sxivansx/major-project/core/obslam/rig.py

"""The bench rig: one lidar source, one tilt servo, the live point cloud and the step-and-scan job.

Thread model: scan sources and the job run on their own threads; `publish` must be thread-safe
(the server hands in a loop.call_soon_threadsafe wrapper). All rig state is guarded by one RLock.
"""

from __future__ import annotations

import json
import logging
import math
import threading
import time
from pathlib import Path
from typing import Callable, Literal

import numpy as np
from pydantic import BaseModel, Field

from . import wire
from .analysis import OpsParams, analyze
from .audio_pipeline import AudioPipeline
from .config import Config
from .geometry import lidar_to_base
from .grid import Grid, build_grid
from .room import RoomSession
from .slam2d import place_at
from .servo import SerialTilt, SimTilt, TiltError, TiltSource
from .session import SessionStore
from .sim import SimScanSource
from .sources import ScanFrame, ScanSource, ScanStats

log = logging.getLogger(__name__)

POINTS_CHUNK = 50_000


class RigError(Exception):
    pass


class JobParams(BaseModel):
    name: str = "scan"
    phi_start: float = -60.0
    phi_end: float = 60.0
    phi_step: float = Field(2.0, gt=0)
    rotations: int = Field(1, ge=1)
    settle_ms: int = Field(300, ge=0)
    # center_out: 0 → phi_start, back to 0, then 0 → phi_end (the cradle never crosses
    # level in one move). linear: phi_start → phi_end in order.
    pattern: Literal["center_out", "linear"] = "center_out"

    def phis(self) -> np.ndarray:
        if abs(self.phi_end - self.phi_start) < 1e-9:
            return np.array([self.phi_start])
        lo, hi = min(self.phi_start, self.phi_end), max(self.phi_start, self.phi_end)
        if self.pattern == "center_out" and lo < 0 < hi:
            def half(limit: float) -> np.ndarray:  # 0, ±step, ... up to `limit`, ends exactly on it
                n = int(np.floor(abs(limit) / self.phi_step + 1e-9))
                v = np.arange(n + 1) * self.phi_step * np.sign(limit)
                return v if abs(v[-1] - limit) < 1e-9 else np.r_[v, limit]
            first, second = (half(lo), half(hi)) if self.phi_start < 0 else (half(hi), half(lo))
            return np.r_[first, second[1:]]  # level is scanned once
        step = self.phi_step if self.phi_end > self.phi_start else -self.phi_step
        return np.arange(self.phi_start, self.phi_end + step / 2, step)


class Rig:
    def __init__(
        self,
        config: Config,
        sessions: SessionStore,
        publish: Callable[[str | bytes], None],
        bridge_path: Path | None = None,
        sim_hz: float = 10.0,
    ):
        self.config = config
        self.sessions = sessions
        self._publish = publish
        self.bridge_path = bridge_path
        self.sim_hz = sim_hz
        self._lock = threading.RLock()
        self._cv = threading.Condition()

        self.scan: ScanSource | None = None
        self.scan_source: str | None = None
        self.scan_port: str | None = None
        self.scan_baud: int | None = None
        self.scan_info: dict = {}
        self.scan_error: str | None = None
        self.stats = ScanStats()
        self.latest: ScanFrame | None = None
        self.seq = 0
        self._last_scan_pub = 0.0
        self._scan_connected_at = 0.0
        self._alarms: set[str] = set()
        self._alarm_keys: dict[str, str] = {}

        self.tilt: TiltSource | None = None

        self.job: dict | None = None
        self._job_thread: threading.Thread | None = None
        self._job_stop = threading.Event()
        self._job_counter = 0

        self._live: list[np.ndarray] = []
        self._live_cat: np.ndarray | None = None
        self.session_loaded: str | None = None
        self.phi_max_deg = 60.0  # of the sweep that produced the live cloud

        # the microphones are a sibling of the lidar, not part of it: their own source thread,
        # their own lock; they only read the map (through a cached analysis) to name candidates
        self.audio = AudioPipeline(config, publish, self.log, self._audio_findings, publish_json=self.publish_json)
        self.room = RoomSession(publish, self.publish_json, self.log)

    def _audio_findings(self) -> dict | None:
        """Findings for the audio candidates: the same defaults as GET /ops/findings, so the ids
        an event names are the ids the operator sees at the default cell size."""
        xyz = self.live_points()
        if xyz.shape[0] < 1000:
            return None
        return analyze(xyz, OpsParams(), scanner_z_m=self.scanner_z_m(), phi_max_deg=self.phi_max_deg).findings

    def scanner_z_m(self) -> float:
        m = self.config.mount
        return (m.axis_z_mm + m.h_mm) / 1000.0

    # ---- publishing -------------------------------------------------------------------------
    def publish_json(self, obj: dict) -> None:
        self._publish(json.dumps(obj))

    def publish_status(self) -> None:
        self.publish_json({"type": "status", **self.status()})

    def log(self, level: str, msg: str) -> None:
        getattr(log, level if level != "warn" else "warning")(msg)
        self.publish_json({"type": "log", "level": level, "msg": msg, "t": time.time()})

    # ---- status ------------------------------------------------------------------------------
    def phi_now(self) -> float:
        with self._lock:
            if self.tilt is None:
                return 0.0
            return self.config.mount.servo_to_phi(self.tilt.servo_deg)

    def live_points(self) -> np.ndarray:
        with self._lock:
            if self._live_cat is None:
                self._live_cat = np.concatenate(self._live) if self._live else np.zeros((0, 3), np.float32)
            return self._live_cat

    def status(self) -> dict:
        with self._lock:
            lidar = {
                "connected": self.scan is not None,
                "source": self.scan_source,
                "port": self.scan_port,
                "baud": self.scan_baud,
                "model": self.scan_info.get("model"),
                "serial": self.scan_info.get("serial"),
                "firmware": self.scan_info.get("firmware"),
                "hardware": self.scan_info.get("hardware"),
                "health": self.scan_info.get("health"),
                "scan_hz": self.stats.hz,
                "pts_per_rev": self.stats.pts_per_rev,
                "range_min_m": self.stats.range_min,
                "range_max_m": self.stats.range_max,
                "error": self.scan_error,
            }
            t = self.tilt
            meas = t.meas_deg if t else None
            servo = {
                "connected": t is not None,
                "port": t.port if t else None,
                "servo_deg": t.servo_deg if t else None,
                "phi_deg": self.config.mount.servo_to_phi(t.servo_deg) if t else None,
                "min_deg": t.min_deg if t else None,
                "max_deg": t.max_deg if t else None,
                "range": t.range if t else None,
                "meas_deg": meas,
                "phi_meas_deg": self.config.mount.enc_to_phi(meas) if meas is not None else None,
                "encoder": t.encoder if t else None,
                "settled": t.settled if t else None,
            }
            return {
                "lidar": lidar,
                "servo": servo,
                "job": dict(self.job) if self.job else None,
                "live_points": int(self.live_points().shape[0]),
                "session_loaded": self.session_loaded,
                "alarms": sorted(self._alarms),
                "audio": self.audio.status(),
            }

    def check_alarms(self) -> list[str]:
        """Called about once a second. Raises/clears alarms with one log line each."""
        # Keyed by kind, so a changing number (6.3 Hz, then 6.6 Hz) updates one alarm instead of
        # raising and clearing a new one every second. Over Wi-Fi the first seconds after connect
        # replay buffered rotations in bursts, hence the longer grace period.
        alarms: dict[str, str] = {}
        now = time.time()
        self.audio.tick(now)  # outside the rig lock: it may publish
        with self._lock:
            if self.scan is not None and now - self._scan_connected_at > 8.0:
                last_t = self.latest.t if self.latest else self._scan_connected_at
                age = now - last_t
                hz = self.stats.hz
                if age > 2.0:
                    alarms["no_frames"] = f"no lidar frames for {age:.0f} s"
                elif hz is not None and hz < 8.0:
                    alarms["rate"] = f"scan rate low: {hz:.1f} Hz"
                if self.stats.pts_per_rev and self.stats.pts_per_rev < 1000:
                    alarms["points"] = f"only {self.stats.pts_per_rev} points per rotation"
                health = self.scan_info.get("health")
                if health not in (None, "good"):
                    alarms["health"] = f"lidar health {health}"
            if self.scan is None and self.scan_error:
                alarms["died"] = f"lidar stream died: {self.scan_error}"
            job = self.job
            if job and job["state"] == "error":
                alarms["job"] = f"job {job['job_id']} failed: {job['error']}"
            alarms.update(self.audio.alarms())
            old = self._alarm_keys
            raised = [alarms[k] for k in alarms if k not in old]
            cleared = [old[k] for k in old if k not in alarms]
            self._alarm_keys = alarms
            self._alarms = set(alarms.values())
        for a in sorted(raised):
            self.log("warn", f"alarm: {a}")
        for a in sorted(cleared):
            self.log("info", f"cleared: {a}")
        if raised or cleared:
            self.publish_status()
        return sorted(alarms.values())

    def snapshot_csv(self, rotations: int = 1, timeout: float = 5.0) -> bytes:
        """The next `rotations` full rotations at the current tilt, raw, as CSV. For bias measurements."""
        with self._lock:
            if self.scan is None:
                raise RigError("lidar not connected")
        frames = self.wait_frames(rotations, time.time(), timeout)
        phi = self.phi_now()
        rows = ["rotation,t,phi,angle,range,quality"]
        for i, f in enumerate(frames):
            for a, r, q in zip(f.angle.tolist(), f.range.tolist(), f.quality.tolist()):
                rows.append(f"{i},{f.t:.4f},{phi:.2f},{a:.3f},{r:.4f},{q}")
        return ("\n".join(rows) + "\n").encode()

    def metrics(self, cell: float | None = None, z_min=None, z_max=None, floor_band_m: float = 0.1) -> dict:
        """Numbers for the evaluation chapter: coverage, throughput, floor flatness."""
        xyz = self.live_points()
        with self._lock:
            job = dict(self.job) if self.job else None
        n = int(xyz.shape[0])
        out: dict = {"points": n, "steps": None, "points_per_step": None, "duration_s": None}
        if job:
            steps = int(job.get("step") or 0)
            out["steps"] = steps
            out["points_per_step"] = round(n / steps, 1) if steps else None
            end = job.get("finished") or (time.time() if job["state"] == "running" else None)
            out["duration_s"] = round(end - job["started"], 2) if end else None
        g = self.grid(cell, "count", z_min, z_max)
        filled = int(np.isfinite(g.data).sum())
        cells = int(g.w * g.h)
        out["grid"] = {
            "cell_m": g.cell,
            "cells": cells,
            "filled": filled,
            "coverage_pct": round(100.0 * filled / cells, 1) if n else 0.0,
            "points_per_filled_cell": round(n / filled, 1) if filled else None,
        }
        band = xyz[np.abs(xyz[:, 2]) <= floor_band_m] if n else xyz
        if band.shape[0] >= 50:
            a = np.c_[band[:, 0], band[:, 1], np.ones(band.shape[0])].astype(np.float64)
            coef, *_ = np.linalg.lstsq(a, band[:, 2].astype(np.float64), rcond=None)
            resid = band[:, 2] - a @ coef
            out["floor"] = {
                "points": int(band.shape[0]),
                "rms_mm": round(float(np.sqrt(np.mean(resid**2)) * 1000), 1),
                "tilt_deg": round(float(np.degrees(np.arctan(np.hypot(coef[0], coef[1])))), 2),
                "offset_mm": round(float(coef[2] * 1000), 1),
            }
        else:
            out["floor"] = None
        return out

    # ---- lidar -------------------------------------------------------------------------------
    def connect_lidar(self, source: str, port: str | None = None, baud: int = 1_000_000) -> None:
        with self._lock:
            if self.scan is not None:
                raise RigError("lidar already connected")
            if source == "sim":
                src: ScanSource = SimScanSource(self.phi_now, self.config.mount, hz=self.sim_hz)
            elif source == "s2":
                if not port:
                    raise RigError("port required for s2")
                from .s2 import S2ScanSource

                src = S2ScanSource(port, baud, self.bridge_path)
            else:
                raise RigError(f"unknown source {source!r}")
            try:
                info = src.info()
            except RuntimeError as e:
                raise RigError(str(e)) from e
            self.scan, self.scan_source, self.scan_port, self.scan_baud = src, source, port, baud
            self.scan_info, self.scan_error = info, None
            self.stats.reset()
            self.latest = None
            self._scan_connected_at = time.time()
            src.start(self._on_frame, self._on_scan_exit)
        self.log("info", f"lidar connected: {info.get('model')} on {port or 'sim'}")
        self.publish_status()

    def disconnect_lidar(self) -> None:
        with self._lock:
            src, self.scan = self.scan, None
            self.scan_source = self.scan_port = self.scan_baud = None
            self.scan_info = {}
            self.stats.reset()
        if src:
            src.stop()
            self.log("info", "lidar disconnected")
        self.publish_status()

    def _on_frame(self, f: ScanFrame) -> None:
        with self._lock:
            self.stats.update(f)
            self.latest = f
            self.seq += 1
            seq = self.seq
            phi = self.phi_now()
        with self._cv:
            self._cv.notify_all()
        now = time.monotonic()
        if now - self._last_scan_pub >= 0.08:
            self._last_scan_pub = now
            self._publish(wire.encode_scan(seq, f.t, phi, f.angle, f.range, f.quality))
        self.room.feed(f, phi)

    def _on_scan_exit(self, error: str | None) -> None:
        with self._lock:
            self.scan = None
            self.scan_error = error or "lidar stream ended"
        self.log("error", f"lidar stream ended: {error or 'no error reported'}")
        self.publish_status()

    def wait_frames(self, n: int, after: float, timeout: float = 5.0) -> list[ScanFrame]:
        """Collect n frames grabbed after `after` (unix s). Raises RigError on timeout."""
        got: list[ScanFrame] = []
        seen = self.seq
        deadline = time.monotonic() + timeout
        while len(got) < n:
            remaining = deadline - time.monotonic()
            if remaining <= 0:
                raise RigError("timed out waiting for lidar frames")
            with self._cv:
                if self.seq == seen:
                    self._cv.wait(remaining)
            with self._lock:
                if self.scan is None:
                    raise RigError("lidar disconnected")
                if self.seq != seen:
                    seen = self.seq
                    if self.latest is not None and self.latest.t >= after:
                        got.append(self.latest)
        return got

    # ---- servo -------------------------------------------------------------------------------
    def connect_servo(self, port: str) -> None:
        with self._lock:
            if self.tilt is not None:
                raise RigError("servo already connected")
            t: TiltSource = SimTilt() if port == "sim" else SerialTilt(port)
            try:
                t.connect()
            except TiltError as e:
                raise RigError(str(e)) from e
            self.tilt = t
        self.log("info", f"servo connected on {port}")
        self.publish_status()

    def disconnect_servo(self) -> None:
        with self._lock:
            t, self.tilt = self.tilt, None
        if t:
            t.disconnect()
            self.log("info", "servo disconnected")
        self.publish_status()

    def _tilt(self) -> TiltSource:
        if self.tilt is None:
            raise RigError("servo not connected")
        return self.tilt

    SERVO_SPEED_DPS = 60.0  # eased moves: degrees per second
    LEVEL_TOL_DEG = 0.5

    def _ease_to(self, t: TiltSource, servo_deg: float) -> float:
        ms = int(abs(servo_deg - t.servo_deg) / self.SERVO_SPEED_DPS * 1000)
        return t.ease(servo_deg, max(ms, 100))

    def move_servo(self, servo_deg: float | None = None, phi_deg: float | None = None) -> float:
        """Eased move. Level (φ = 0, the configured centre) is home: a move from one side of
        level to the other stops at level first, so the cradle never swings across in one go."""
        with self._lock:
            t = self._tilt()
            mount = self.config.mount
            if servo_deg is None:
                if phi_deg is None:
                    raise RigError("servo_deg or phi_deg required")
                servo_deg = mount.phi_to_servo(phi_deg)
            if not (t.min_deg <= servo_deg <= t.max_deg):
                raise RigError(f"servo {servo_deg:.1f}° outside limits [{t.min_deg}, {t.max_deg}]")
            now_phi = mount.servo_to_phi(t.servo_deg)
            to_phi = mount.servo_to_phi(servo_deg)
            try:
                if abs(now_phi) > self.LEVEL_TOL_DEG and abs(to_phi) > self.LEVEL_TOL_DEG and now_phi * to_phi < 0:
                    self._ease_to(t, mount.center_deg)
                deg = self._ease_to(t, servo_deg)
            except TiltError as e:
                raise RigError(str(e)) from e
        self.publish_status()
        return deg

    def home_servo(self) -> float:
        """Home is level: φ = 0 at the calibrated centre (Mount and filters → Centre)."""
        return self.move_servo(phi_deg=0.0)

    def servo_raw(self, line: str) -> str:
        with self._lock:
            t = self._tilt()
            try:
                reply = t.raw(line)
                if line.strip().split()[:1] and line.strip().split()[0].upper() in ("C", "L", "?", "T", "S", "H", "W", "E"):
                    t.refresh()
            except TiltError as e:
                raise RigError(str(e)) from e
        self.publish_status()
        return reply

    # ---- job ---------------------------------------------------------------------------------
    def start_job(self, params: JobParams) -> int:
        with self._lock:
            if self.job and self.job["state"] == "running":
                raise RigError("a job is already running")
            if self.scan is None:
                raise RigError("lidar not connected")
            self._tilt()
            if self.scan_source != "sim" and isinstance(self.tilt, SimTilt):
                raise RigError(
                    "the servo is simulated, so the real LiDAR would not tilt: connect the ESP32 servo "
                    "before sweeping (the Live scan tab works without it)"
                )
            phis = params.phis()
            for phi in (float(phis[0]), float(phis[-1])):
                s = self.config.mount.phi_to_servo(phi)
                if not (self.tilt.min_deg <= s <= self.tilt.max_deg):
                    raise RigError(f"phi {phi:.1f}° needs servo {s:.1f}°, outside limits")
            station = self.room.station_pose()
            self._job_counter += 1
            job_id = self._job_counter
            self.job = {
                "job_id": job_id,
                "name": params.name,
                "state": "running",
                "step": 0,
                "n_steps": int(phis.shape[0]),
                "phi_deg": float(phis[0]),
                "points": 0,
                "started": time.time(),
                "eta_s": None,
                "error": None,
                # room mapping on track: this sweep is one station of a multi-station room cloud
                "station": None if station is None else {"x": round(station[0], 3), "y": round(station[1], 3), "theta_deg": round(math.degrees(station[2]), 1)},
            }
            if station is None:
                self._live.clear()
            else:
                self.room.hold(True)
            self._live_cat = None
            self.session_loaded = None
            self.phi_max_deg = float(max(abs(params.phi_start), abs(params.phi_end)))
            self._job_stop.clear()
            self._job_thread = threading.Thread(
                target=self._run_job, args=(params, job_id, phis, station), name=f"job-{job_id}", daemon=True
            )
            self._job_thread.start()
        self.log("info", f"job {job_id} '{params.name}' started: {len(phis)} steps")
        self.publish_status()
        return job_id

    def stop_job(self) -> None:
        self._job_stop.set()
        t = self._job_thread
        if t and t is not threading.current_thread():
            t.join(timeout=10)

    def _publish_job(self) -> None:
        with self._lock:
            if self.job:
                self.publish_json({"type": "job", **self.job})

    def _settle(self, settle_ms: int) -> float | None:
        """Wait for the cradle to stop moving. Returns the measured tilt φ when an encoder exists, else None.

        With an encoder the firmware's W command waits for mechanical stability (settle_ms is its timeout
        margin); without one we can only sleep for settle_ms.
        """
        with self._lock:
            t = self._tilt()
            has_enc = t.meas_deg is not None
        if not has_enc:
            if settle_ms:
                self._job_stop.wait(settle_ms / 1000)
            return None
        # W blocks inside the firmware for up to its timeout. The serial port has its own lock, so the rig
        # lock is deliberately NOT held here: scan frames and status must keep flowing while the cradle settles.
        try:
            settled = t.wait_settled(settle_ms + 1000)
            t.refresh()
        except TiltError as e:
            raise RigError(str(e)) from e
        meas = t.meas_deg
        if not settled:
            self.log("warn", "encoder did not settle in time, using its last reading")
        return self.config.mount.enc_to_phi(meas) if meas is not None else None

    def _run_job(self, params: JobParams, job_id: int, phis: np.ndarray, station: tuple[float, float, float] | None = None) -> None:
        cfg = self.config
        cols = {k: [] for k in ("step", "phi", "phi_meas", "theta", "range", "quality", "t")}
        last_grid = 0.0
        t0 = time.monotonic()
        state, error = "done", None
        try:
            for i, phi in enumerate(phis):
                phi = float(phi)
                if self._job_stop.is_set():
                    state = "stopped"
                    break
                self.move_servo(phi_deg=phi)
                phi_meas = self._settle(params.settle_ms)
                if self._job_stop.is_set():
                    state = "stopped"
                    break
                phi_used = phi if phi_meas is None else phi_meas
                if phi_meas is not None and abs(phi_meas - phi) > 2.0:
                    self.log("warn", f"step {i}: encoder reads φ {phi_meas:.1f}°, commanded {phi:.1f}°")
                after = time.time()
                frames = self.wait_frames(params.rotations + 1, after)[1:]  # drop the first (stale rotation)
                ths, rs, qs, ts = [], [], [], []
                for f in frames:
                    keep = (f.quality >= cfg.lidar.min_quality) & (f.range >= cfg.lidar.min_range_m)
                    keep &= f.range <= cfg.lidar.max_range_m
                    ths.append(f.angle[keep])
                    rs.append(f.range[keep])
                    qs.append(f.quality[keep])
                    ts.append(np.full(int(keep.sum()), f.t))
                theta = np.concatenate(ths) if ths else np.zeros(0, np.float32)
                rng = np.concatenate(rs) if rs else np.zeros(0, np.float32)
                xyz = lidar_to_base(theta, rng, phi_used, cfg.mount)
                if station is not None:
                    xyz = place_at(xyz, station)
                cols["step"].append(np.full(theta.shape[0], i, np.uint16))
                cols["phi"].append(np.full(theta.shape[0], phi, np.float32))
                cols["phi_meas"].append(np.full(theta.shape[0], np.nan if phi_meas is None else phi_meas, np.float32))
                cols["theta"].append(theta.astype(np.float32))
                cols["range"].append(rng.astype(np.float32))
                cols["quality"].append(np.concatenate(qs) if qs else np.zeros(0, np.uint8))
                cols["t"].append(np.concatenate(ts) if ts else np.zeros(0, np.float64))
                with self._lock:
                    self._live.append(xyz)
                    self._live_cat = None
                    total = sum(a.shape[0] for a in self._live)
                    per_step = (time.monotonic() - t0) / (i + 1)
                    self.job.update(step=i + 1, phi_deg=phi, points=total, eta_s=per_step * (len(phis) - i - 1))
                self._publish(wire.encode_points(job_id, i, phi, xyz))
                self._publish_job()
                if time.monotonic() - last_grid >= 1.0:
                    last_grid = time.monotonic()
                    self._publish(wire.encode_grid(self.grid()))
                    self.audio.map_changed()
        except RigError as e:
            state, error = "error", str(e)
        except Exception as e:  # noqa: BLE001
            log.exception("job %d crashed", job_id)
            state, error = "error", f"{type(e).__name__}: {e}"
        # every sweep ends level, whatever happened
        try:
            self.home_servo()
        except RigError as e:
            log.warning("job %d: could not return to level: %s", job_id, e)
        if station is not None:
            self.room.hold(False)

        sid = None
        n_total = sum(a.shape[0] for a in cols["theta"])
        try:
            if n_total:
                arrays = {k: np.concatenate(v) for k, v in cols.items()}
                sid = self.sessions.new_id(params.name)
                meta = {
                    "id": sid,
                    "name": params.name,
                    "created": time.time(),
                    "n_points": int(n_total),
                    "n_steps": int(len(phis)),
                    "phi_start": params.phi_start,
                    "phi_end": params.phi_end,
                    "phi_step": params.phi_step,
                    "rotations": params.rotations,
                    "settle_ms": params.settle_ms,
                    # the raw columns stay in the scanner frame; this is where the station stood in the room map
                    "station": None if station is None else {"x": station[0], "y": station[1], "theta_rad": station[2]},
                    "state": state,
                    "encoder": self.tilt.encoder if self.tilt else None,
                    "lidar": {k: self.scan_info.get(k) for k in ("model", "serial", "firmware")},
                    "mount": cfg.mount.model_dump(),
                }
                self.sessions.save(meta, arrays)
        except Exception as e:  # noqa: BLE001  (a job must never stay "running" because the save failed)
            log.exception("job %d: saving the session failed", job_id)
            state, error, sid = "error", f"save failed: {type(e).__name__}: {e}", None
        with self._lock:
            self.job.update(state=state, error=error, eta_s=0.0, session_id=sid, finished=time.time())
            self.session_loaded = sid
        self._publish(wire.encode_grid(self.grid()))
        self.audio.map_changed()
        self._publish_job()
        if state == "error":
            self.log("error", f"job {job_id} failed: {error}")
        else:
            self.log("info", f"job {job_id} {state}: {n_total} points" + (f", saved {sid}" if sid else ""))
        self.publish_status()

    # ---- grid & sessions ---------------------------------------------------------------------
    def grid(self, cell: float | None = None, layer: str | None = None, z_min=None, z_max=None) -> Grid:
        g = self.config.grid
        return build_grid(
            self.live_points(),
            cell or g.cell_m,
            g.z_min_m if z_min is None else z_min,
            g.z_max_m if z_max is None else z_max,
            layer or g.layer,
        )

    def load_session(self, sid: str) -> None:
        if self.job and self.job["state"] == "running":
            raise RigError("stop the running job first")
        try:
            xyz = self.sessions.points(sid)
        except KeyError:
            raise RigError(f"no session {sid}") from None
        meta = self.sessions.get(sid)
        with self._lock:
            self._live = [xyz]
            self._live_cat = None
            self.session_loaded = sid
            self.phi_max_deg = float(max(abs(meta.get("phi_start", 60)), abs(meta.get("phi_end", 60))))
        for i in range(0, xyz.shape[0], POINTS_CHUNK):
            self._publish(wire.encode_points(0, i // POINTS_CHUNK, 0.0, xyz[i : i + POINTS_CHUNK]))
        self._publish(wire.encode_grid(self.grid()))
        self.audio.map_changed()
        self.log("info", f"session {sid} loaded: {xyz.shape[0]} points")
        self.publish_status()

    def clear_live(self) -> None:
        with self._lock:
            self._live.clear()
            self._live_cat = None
            self.session_loaded = None
        self.audio.map_changed()
        self.publish_status()

    def shutdown(self) -> None:
        self.room.stop()
        self.stop_job()
        self.disconnect_lidar()
        self.disconnect_servo()
        self.audio.disconnect()
