sxivansx/major-project/(commit log)

2026-10-22 docs: driver, servo and dashboard contracts
2026-10-22 core: config, lidar-to-base geometry, 2.5D grid and wire formats
2026-10-22 core: scan sources (S2 bridge, ray-cast simulator) and servo tilt protocol
2026-10-22 driver: C++ S2 bridge over Slamtec SDK, frame checker with fake stream
2026-10-22 core: test S2ScanSource against the bridge's fake stream; fix model id example
    [test_s2.py]
2026-10-22 core: a clean bridge exit ends the stream without an error
    [s2.py]
2026-10-22 firmware: ESP32 servo tilt sketch with line protocol and NVS calibration
2026-10-22 docs: note the servo recentres when the port opens
2026-10-22 web: mount and filter config panel, height map PNG export
2026-10-22 core: AS5600 encoder tilt, 180° servo defaults, job never sticks in running
2026-10-22 web: encoder readout and encoder centre/invert in the mount panel
2026-10-22 web: mock config carries the encoder fields
2026-10-22 firmware: AS5600 encoder, W settle wait, E diagnostics, GS2010MG 180° defaults
2026-10-22 core: route goals snap to an object's edge; wall-like obstacles flagged and described to Jev
    [ai.py, analysis.py, server.py, test_analysis.py]
2026-10-22 core: route goals snap only within the region reachable from the start
    [analysis.py, test_analysis.py]
2026-10-22 web: port fields accept tcp:// (ESP32 Wi-Fi relay); S3 labels
2026-10-22 firmware: LiDAR UART pass-through and Wi-Fi (TCP 8899 LiDAR, 8900 tilt, N command, mDNS)
2026-10-22 core: refuse a sweep with the real LiDAR and a simulated servo
2026-10-23 firmware: hardware team's pin map (servo 17, LiDAR 13/14, I2C 11/12), servo limited to 1400-1600 us, SLAM-Test access point always on
2026-10-23 firmware: 1 MB PSRAM ring for LiDAR over Wi-Fi so stalls delay instead of dropping; buf= in STATUS
    [servo_tilt.ino]
2026-10-23 core: tilt over Wi-Fi reconnects once and repeats the command when the ESP32 drops the socket
2026-10-23 core: refresh servo state after any console move
2026-10-23 docs: settle acoustic contract details (yaw convention, kind-5 layout, tdoa sign, candidates, nulls)
2026-10-23 core: acoustic layer (spike detector, GCC-PHAT direction finding, candidates, clap calibration, TCP and sim sources); contract additions
2026-10-23 web: sound sources on the map and Sound tab, mic-health strip, clap calibration wizard
2026-10-23 core: speech listener flags spoken calls for help with a bearing
2026-10-23 core: room mapping session on the live LiDAR, room endpoints and kind-6 frame
2026-10-23 web: speech and room contract (types, kind-6 frame, REST, WS, stores)
2026-10-23 web: product name On-board SLAM
2026-10-23 docs: product name On-board SLAM
2026-10-23 docs: Phase-I deck, On-board SLAM
2026-10-25 docs: rig, CAD and dashboard images for the readme
2026-10-25 docs: driver readme covers the S3, the Wi-Fi relay (--tcp) and a flag table
2026-10-25 docs: contract overview shows the Wi-Fi links; S3 pin defaults, --tcp, C default range
2026-10-25 docs: firmware soft limits start at L 81 99; contents line; no references to the missing wiring doc
2026-10-25 docs: bring-up runbook with S3 pins, LiDAR over Wi-Fi, opening the soft limits, microphones
2026-10-25 docs: setup mentions Ethernet for internet and the 81-99 servo limit
